TUT-ProjectEV/TSAL-board/README.md

# "Repository name"

## Overview
- "This Repository Overview"

## Requirement
### Development
- "Development Tool Name"
### Boards
- "Platform Name, Board Name, etc..."
### Libraries
- "Library Name and Version used in this repository"

## Usage
- "How to Use, SIMPLE Explanation"

## Features
- "Detailed Description"

## Reference
- ["Reference Site Name"]("Reference URL")

## Author
- ["Your Name"]("Your GitHub, Twitter, etc... Account URL")

## License
- Copyright (c) 2023 東京工科大学 ProjectEV [Released under the MIT license]("License URL")
