TUT-ProjectEV/TSAL-board/(commit log)

2024-04-25 create project, add ignore folder
    [TSAL-board.kicad_pcb, TSAL-board.kicad_sch]
2024-04-25 素子追加
    [TSAL-board.kicad_sch]
